zer0ohm/PDB/PDB24100-x_PCBr2_3dview_front.png

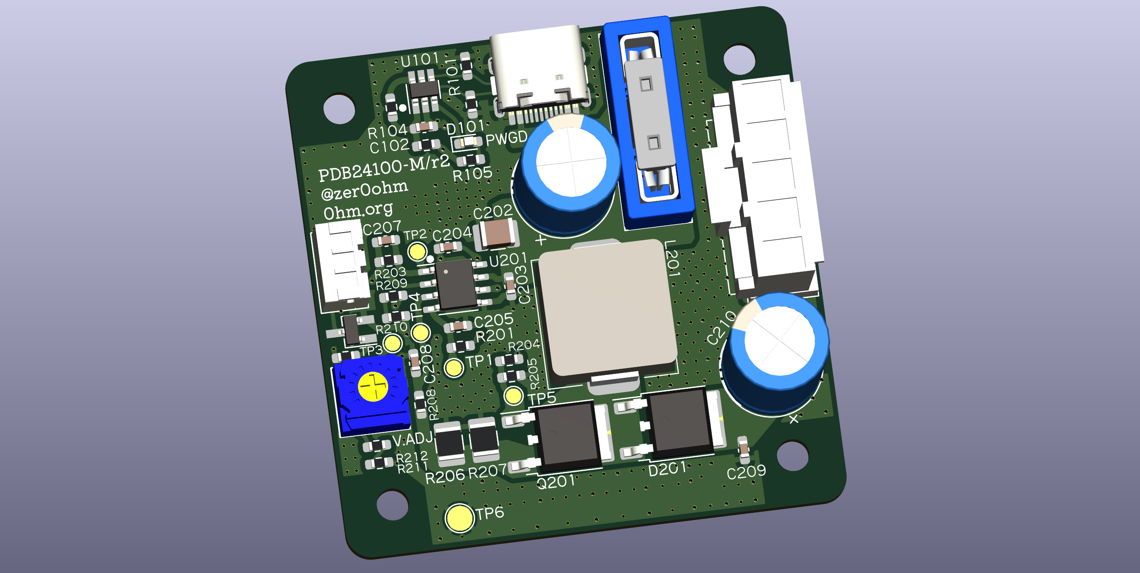
PDB24100-x_PCBr2_3dview_front.png
