zer0ohm/PDB/PDB24100-x_PCBr2_3dview_bottom.png

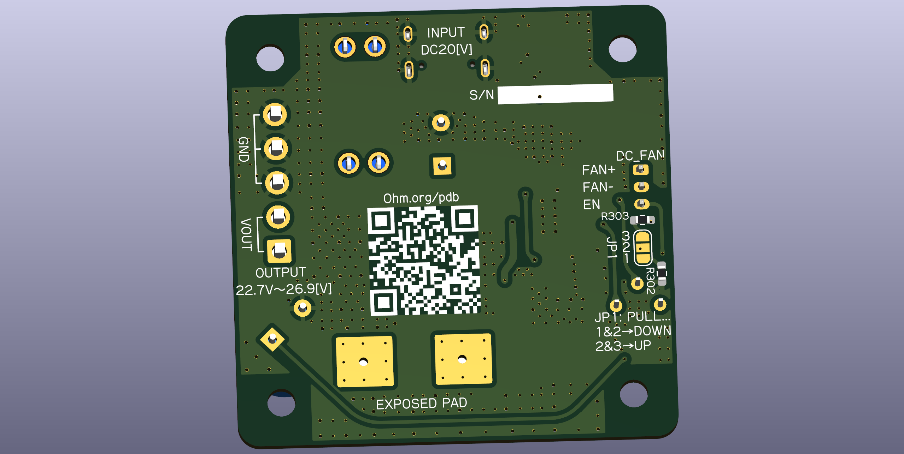
PDB24100-x_PCBr2_3dview_bottom.png
