zer0ohm/PDB/README.md

# PDB
Mini powersupply powered by USB-PD adapter or battery

## misc
[Kicanvas(Preview KiCad design file on web)](https://kicanvas.org/?github=https://github.com/zer0ohm/PDB/blob/schv3_pcbr2/PDB24100-x_PCBr2.kicad_pcb)
