zer0ohm/PDB/PDB24100-x_PCBr2_sch.pdf

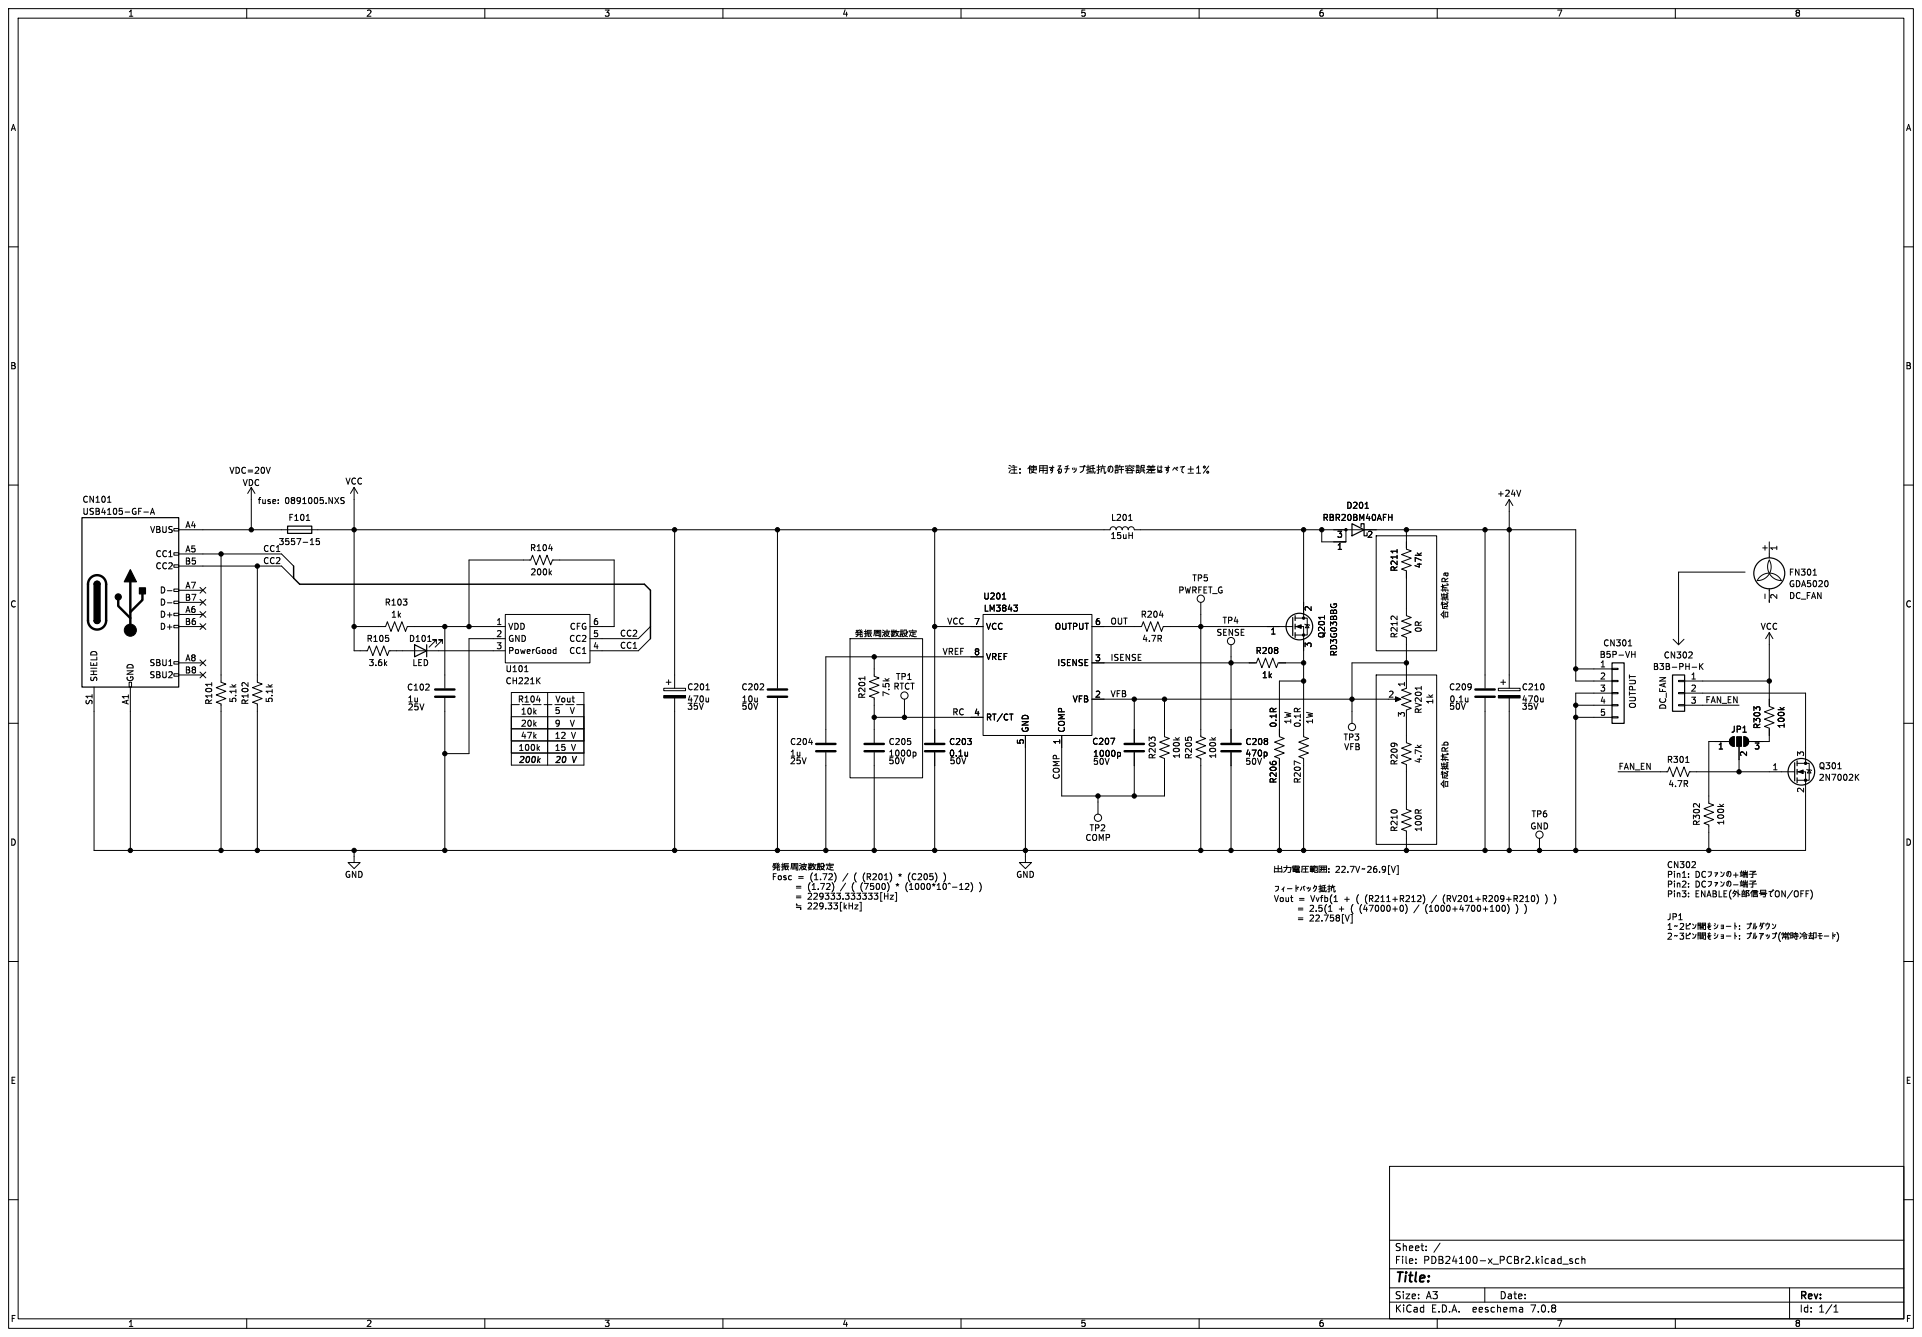
[picture p3: page 1]

þÿlè:þÿO•u(0Y0‹0Á0Ã0×bµb—0nŠ1[¹Š¤]î0o0Y0y0f±1%

þÿQúR›–ûW'{ÄVò: þÿ22.7Vÿ^26.9[V]
