zer0ohm/PDB/CHANGELOG.md

## SCHv1_PCBr0
2024/1/17 出図
- 特記なし

## SCHv2_PCBr1
2024/Mar/21 出図
- [追加] USB-PDコントローラのPowerGood機能を使用した通電確認LEDを追加 ```#1```
  - LED(D101): SML-E12P8WT86 ×1
  - 抵抗(R105): 3.6kΩ ×1
- [追加] 冷却ファン制御MOSFETのゲートプルアップ抵抗と切替はんだジャンパを追加 ```#2```
  - 抵抗(R303): 100kΩ ×1
  - はんだジャンパ(JP1, 基板パターン)
- [追加] 電源ICデバッグ用テストポイントを追加 ```#3```
  - TP1: RTCT(発振器)
  - TP2: COMP(補償器)
  - TP3: VFB(フィードバック)
  - TP4: SENSE(電流検出)
  - TP5: PWRFET_G(スイッチング段MOSFETゲート端子)
  - TP6: GND 
- [追加] 冷却シート「クールスタッフ」の加工治具を追加 **ベータ版** ```#4```
  - User.2/User.3レイヤとjigディレクトリを参照
- [変更] スイッチング段のMOSFETとダイオードを変更 ```#5```
  - MOSFET(Q201): TPH11006NL→RD3G03BBG
  - ダイオード(D201): STPS3045DJF→RBR20BM40AFH
- [変更] フィードバックの分圧抵抗結線を変更 ```#6```
  - 1～2ピン間を基板パターン側で配線
- [修正] 冷却ファンに供給する電力の給電点をVBUS直結から電源ヒューズ(F101)経由に変更 ```#7```
- [修正] VHコネクタの抜け留めとヒューズホルダが干渉する問題を修正 ```#8```

## SCHv3_PCBr2
2024/Apr/ 出図予定
- [変更] フィードバック分圧抵抗の抵抗値変更 ```#1```
  - R209: 1kΩ→4.7kΩ
  - R210: 13Ω→100Ω
  - R211: 7.5kΩ→47kΩ
  - R212: 240Ω→0Ω
  - RV201: 2kΩ→1kΩ
  - →許容誤差±5%品のチップ抵抗で実験し, 23.4～27.5V程度になる事を確認
- [変更] 半固定抵抗を変更 ```#2```
  - RV201: 3362P-1-202LF→GF063P B102K
- [修正] ```SCHv2_PCBr1#8``` で発生した基板パターン変更を適用していなかったミスを修正 ```#3```
- [修正] 基板裏面の一部シルクスクリーンを修正 ```#4```
- [修正] 回路側の変更をBOMに反映 ```#5```
