zer0ohm/PDB/(commit log)

2024-04-12 Add files via upload
    beta release
    [PDB24100-x_PCBr2.kicad_pcb, PDB24100-x_PCBr2.kicad_sch]
2024-04-12 Create CHANGELOG.md
    改版履歴を追加
